laotawayi/-/微信图片_20240506144101.png

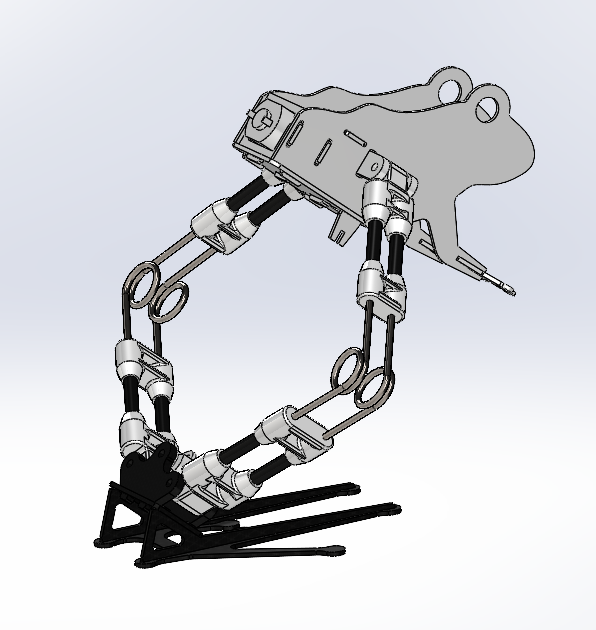
微信图片_20240506144101.png
