laotawayi/-/防尘板.STL

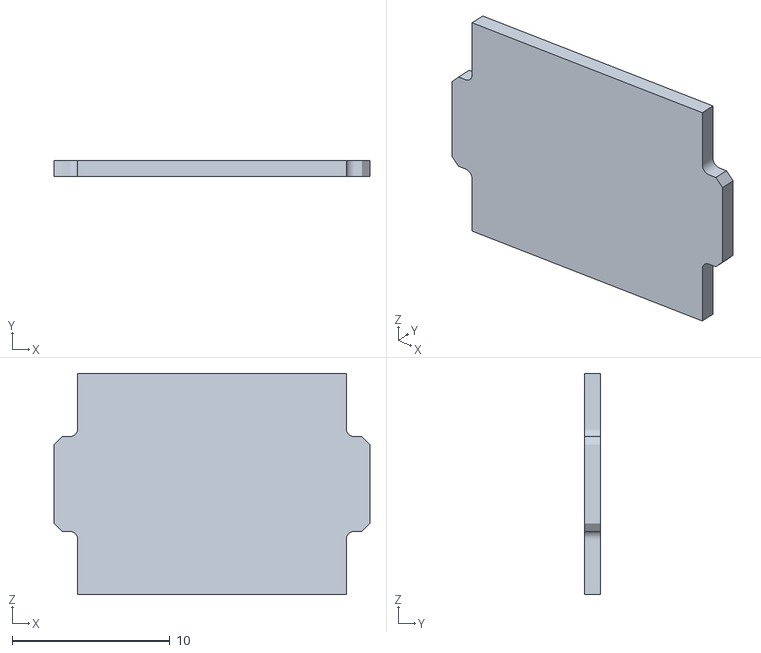
[picture p31: CAD file, 2024-05-06]
防尘板.STL
20.0 x 1.00 x 14.0
