laotawayi/-/腿加强筋.STL

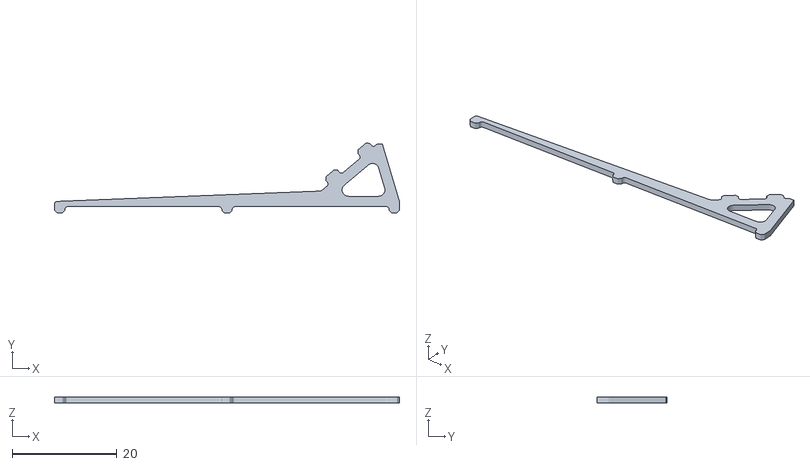
[picture p32: CAD file, 2024-05-06]
腿加强筋.STL
66.0 x 13.4 x 1.10
