laotawayi/-/挂钩V2.STL

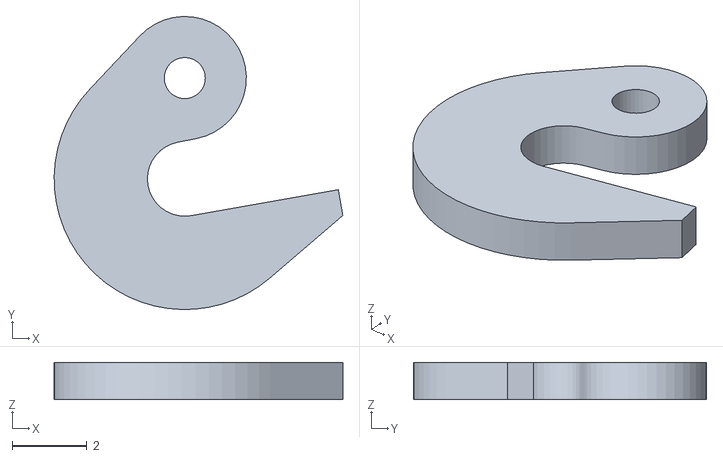
[picture p33: CAD file, 2024-05-06]
挂钩V2.STL
7.73 x 7.85 x 1.00
