laotawayi/-/底5.3.STL

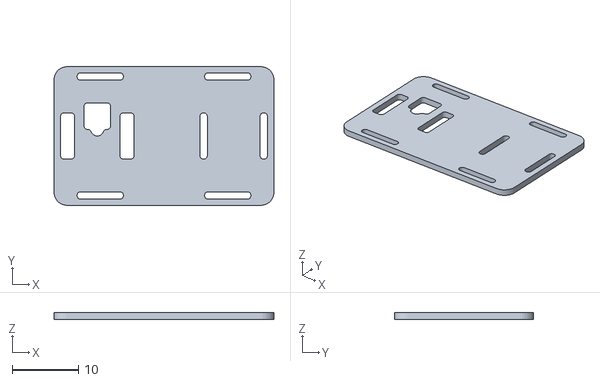
[picture p34: CAD file, 2024-05-06]
底5.3.STL
33.3 x 21.0 x 1.00
