laotawayi/-/正旋1.5mm扭簧.STL

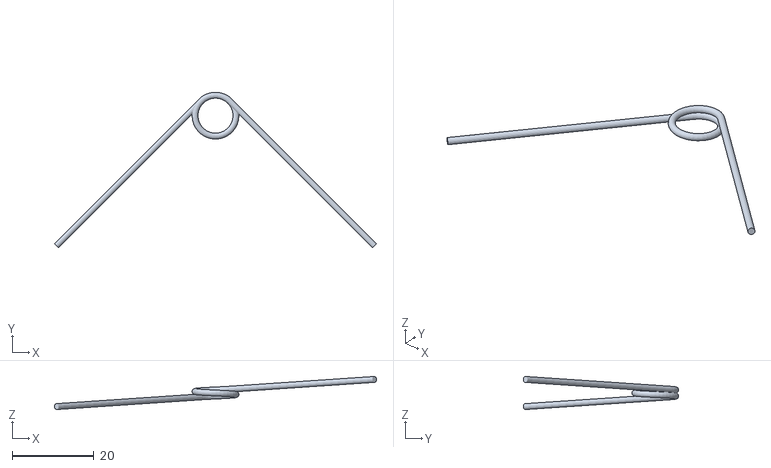
[picture p35: CAD file, 2024-05-06]
正旋1.5mm扭簧.STL
78.7 x 38.0 x 8.09
