laotawayi/-/转轴233.3.STL

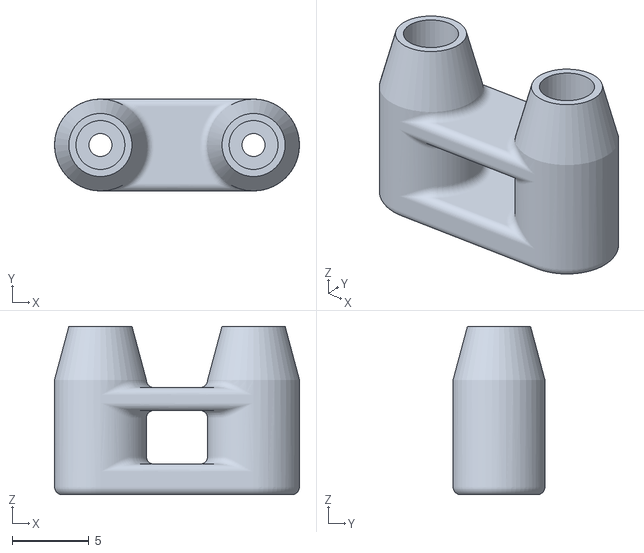
[picture p36: CAD file, 2024-05-06]
转轴233.3.STL
16.0 x 6.00 x 11.0
