laotawayi/-/转轴23.3.STL

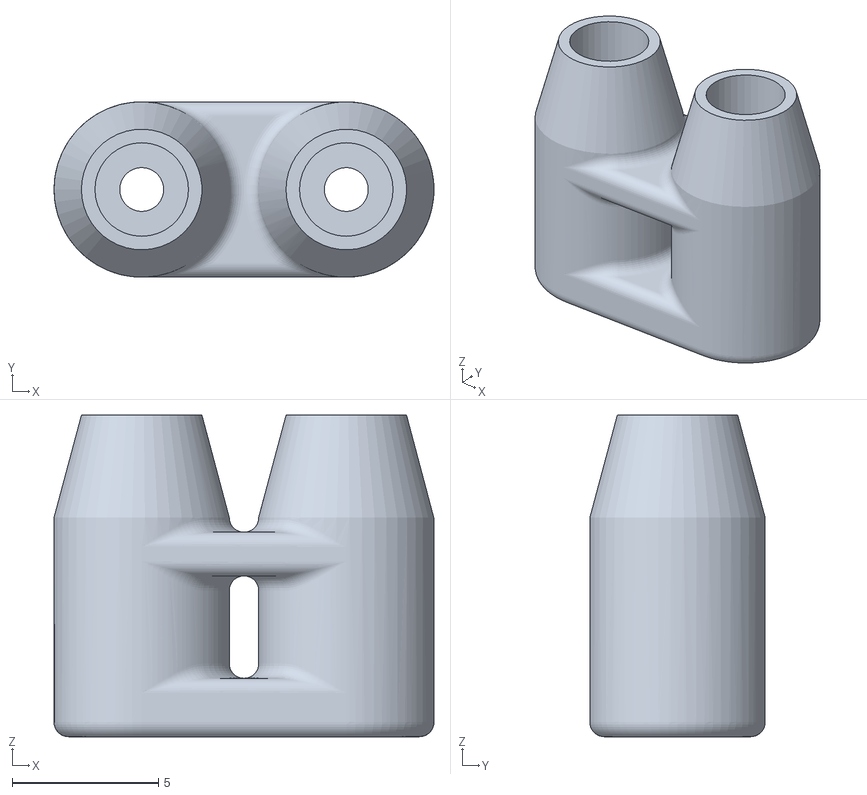
[picture p37: CAD file, 2024-05-06]
转轴23.3.STL
13.0 x 6.00 x 11.0
