laotawayi/-/电机.STL

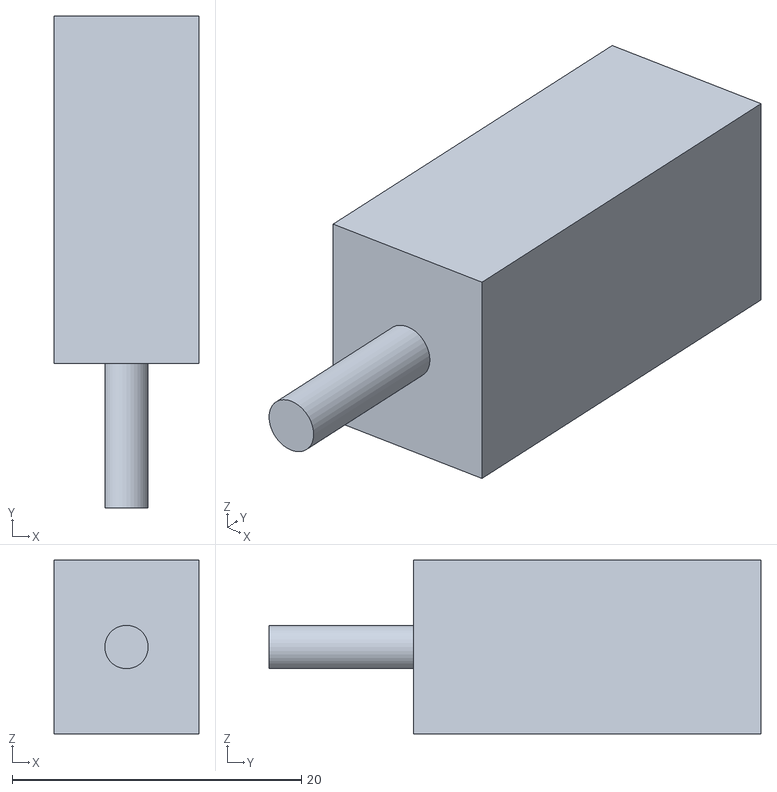
[picture p38: CAD file, 2024-05-06]
电机.STL
10.0 x 34.0 x 12.0
