laotawayi/-/脚底板5.3.STL

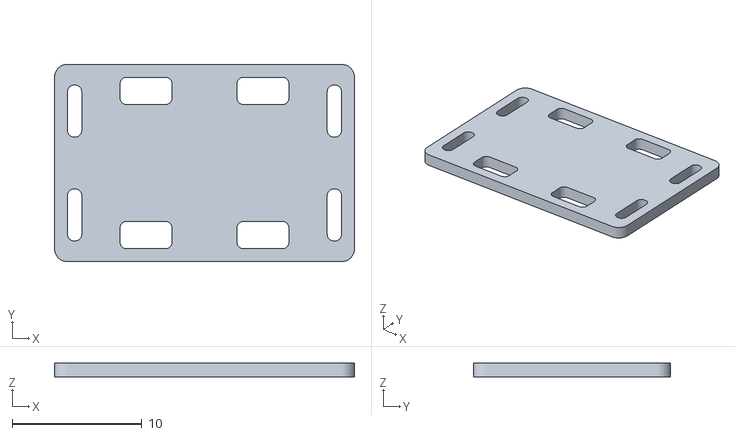
[picture p39: CAD file, 2024-05-06]
脚底板5.3.STL
23.1 x 15.2 x 1.10
