laotawayi/-/侧样子货３.STL

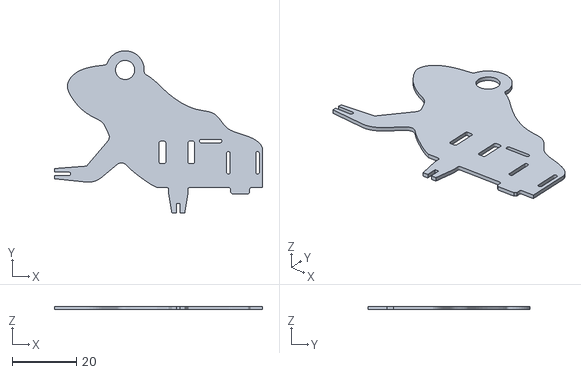
[picture p40: CAD file, 2024-05-06]
侧样子货３.STL
65.0 x 50.7 x 1.00
