laotawayi/-/转轴V5.1.STL

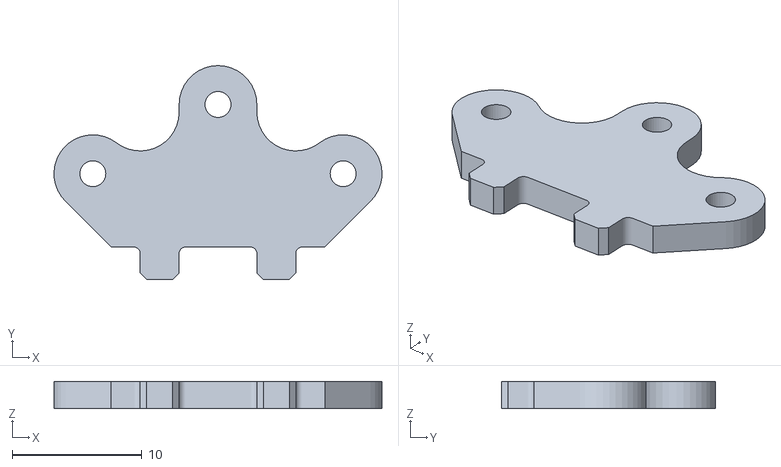
[picture p41: CAD file, 2024-05-06]
转轴V5.1.STL
25.3 x 16.5 x 2.10
