laotawayi/-/轴5.3.STL

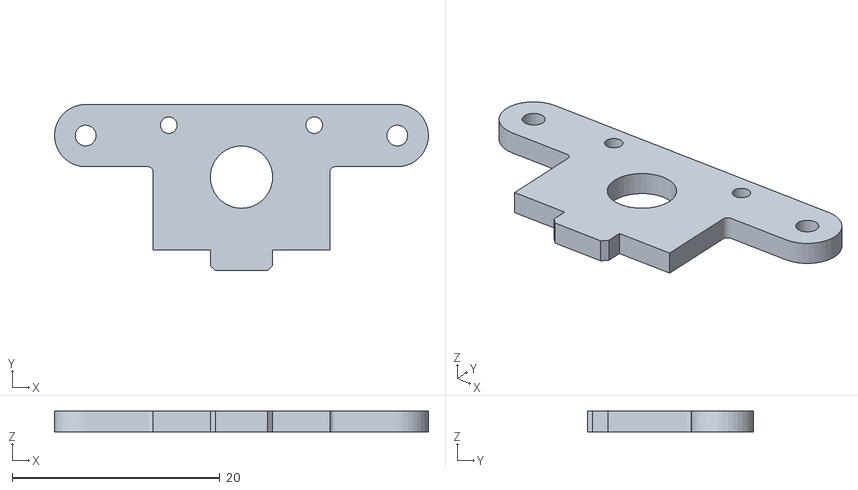
[picture p42: CAD file, 2024-05-06]
轴5.3.STL
36.0 x 16.0 x 2.00
