laotawayi/-/侧样子货.STL

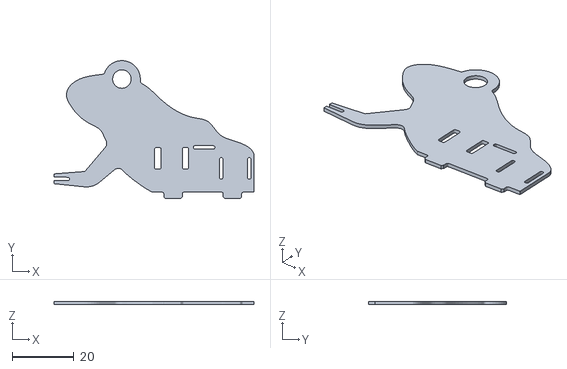
[picture p43: CAD file, 2024-05-06]
侧样子货.STL
65.0 x 44.7 x 1.00
