laotawayi/-/转轴3.3.STL

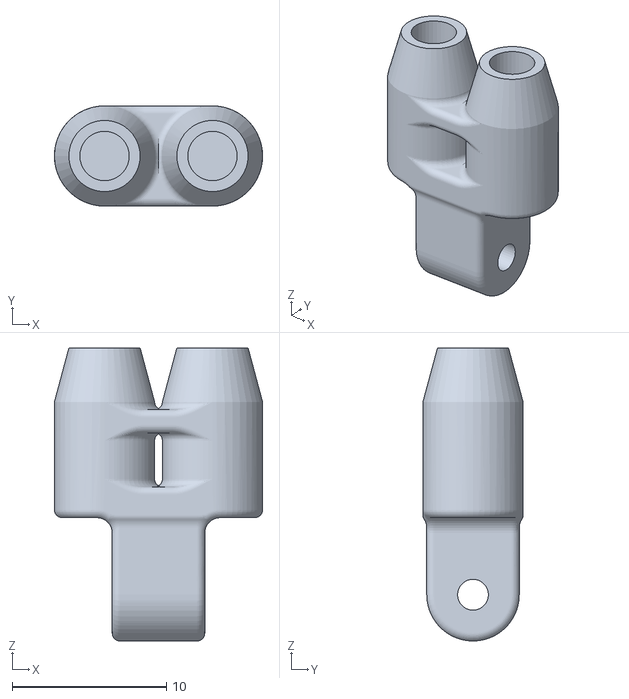
[picture p44: CAD file, 2024-05-06]
转轴3.3.STL
13.5 x 6.50 x 19.0
