laotawayi/-/轴25.3.STL

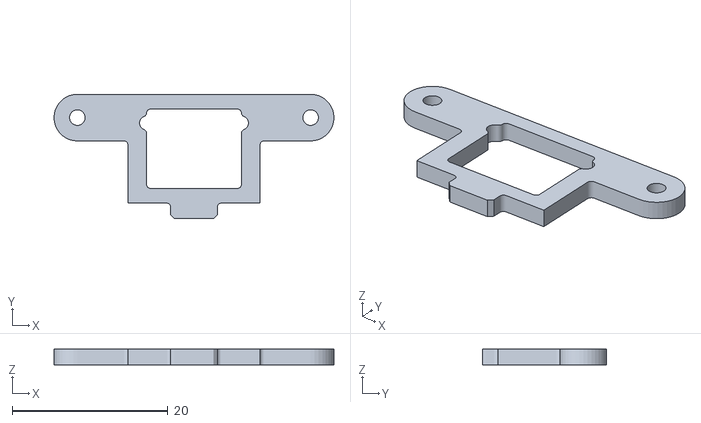
[picture p45: CAD file, 2024-05-06]
轴25.3.STL
36.0 x 16.0 x 2.00
