laotawayi/-/盒子.STL

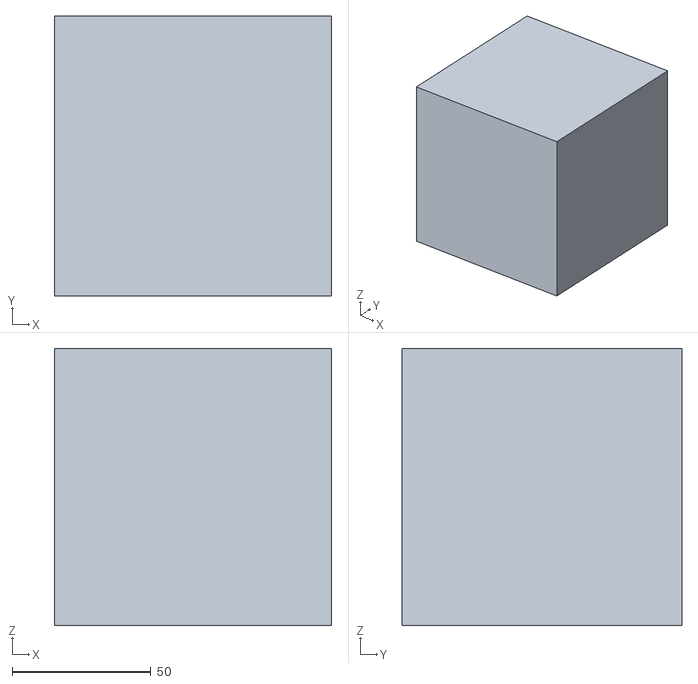
[picture p46: CAD file, 2024-05-06]
盒子.STL
100.0 x 101.0 x 100.0
