laotawayi/-/1.5碳纤维管.STL

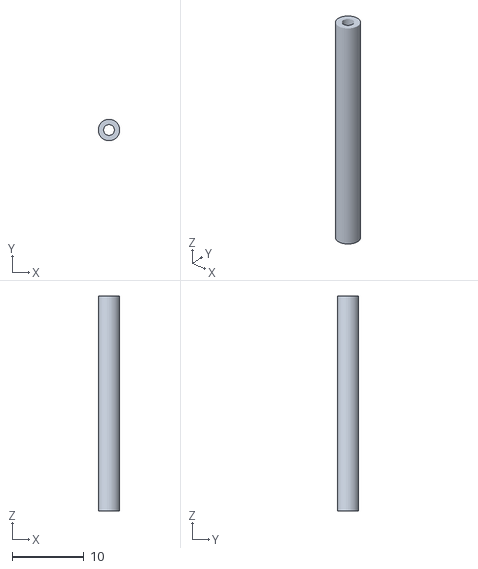
[picture p47: CAD file, 2024-05-06]
1.5碳纤维管.STL
3.00 x 3.00 x 30.0
