laotawayi/-/脚，加强.STL

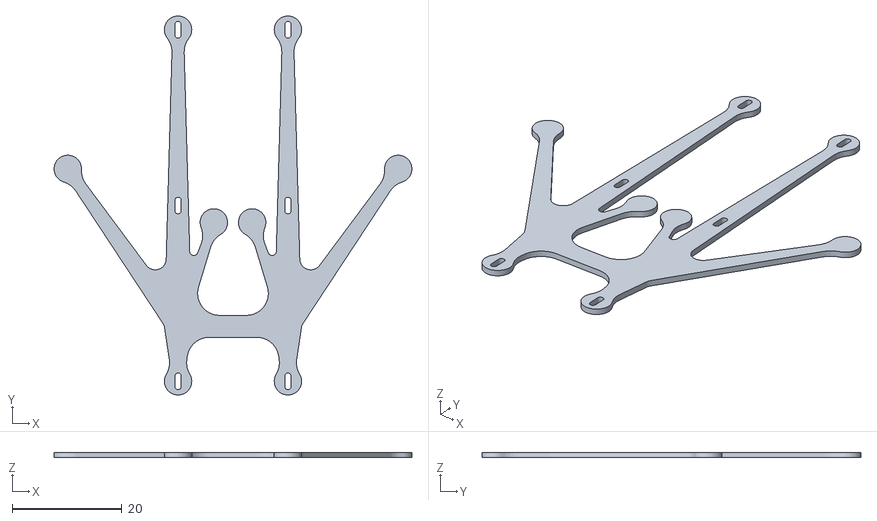
[picture p48: CAD file, 2024-05-06]
脚，加强.STL
65.1 x 69.0 x 1.00
