laotawayi/-/释放开关.STL

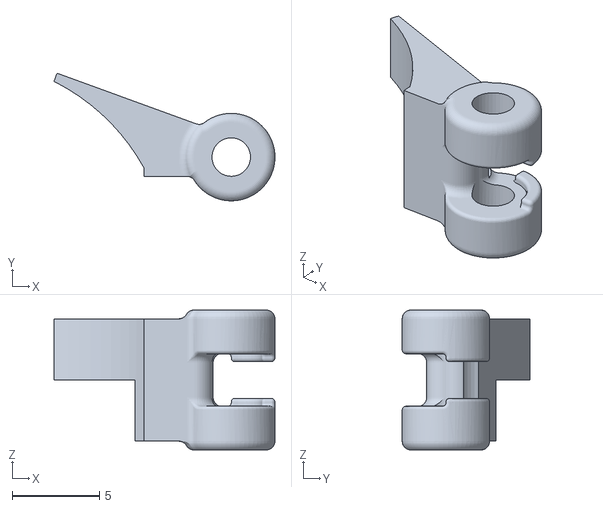
[picture p49: CAD file, 2024-05-06]
释放开关.STL
12.6 x 7.30 x 8.00
