laotawayi/-/前脚掌.STL

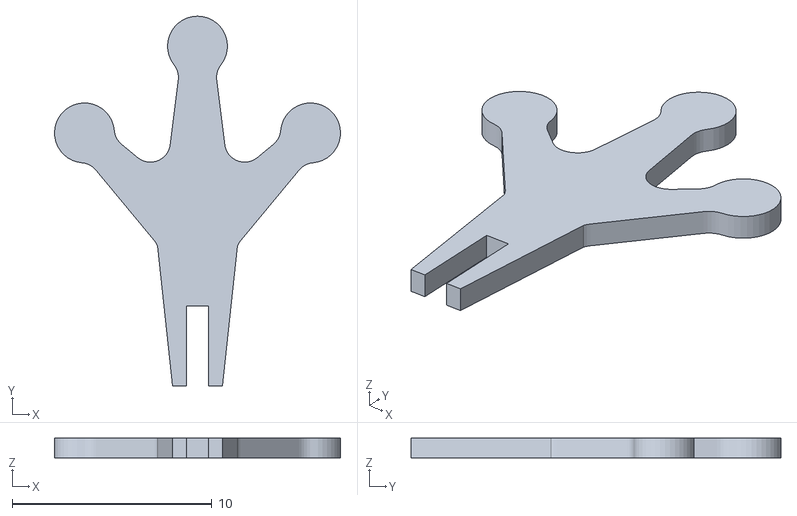
[picture p50: CAD file, 2024-05-06]
前脚掌.STL
14.3 x 18.5 x 1.00
