laotawayi/-/电机仓.STL

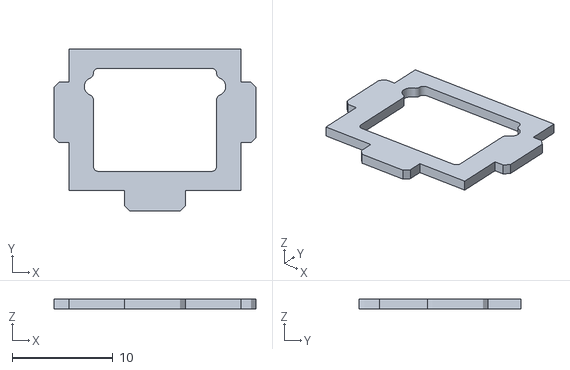
[picture p51: CAD file, 2024-05-06]
电机仓.STL
20.0 x 16.0 x 1.00
