laotawayi/-/转轴33.3.STL

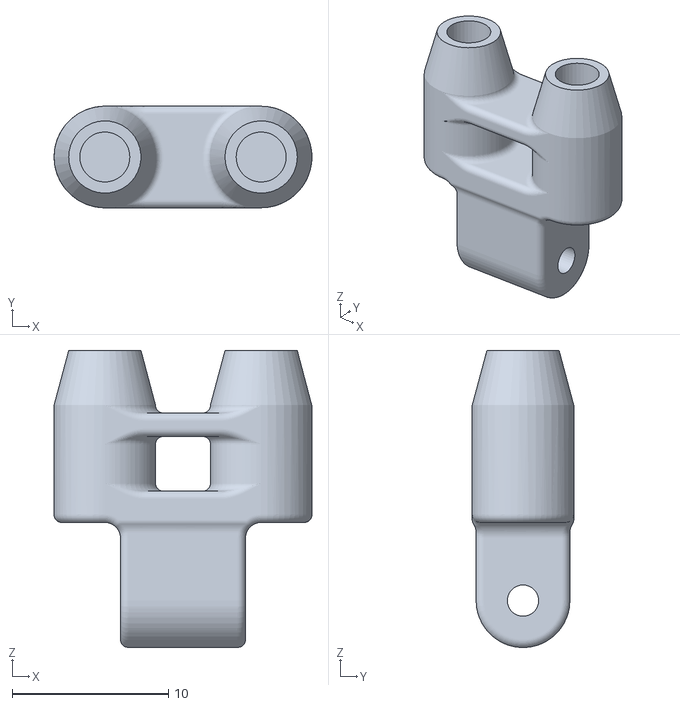
[picture p52: CAD file, 2024-05-06]
转轴33.3.STL
16.5 x 6.50 x 19.0
