laotawayi/-/(list of files, cad)

Other CAD files:
反旋1.5mm扭簧.STL
