laotawayi/-/(commit log)

2024-05-06 Add files via upload
    青蛙的模型文件
    [1.5碳纤维管.STL, 侧样子货.STL, 侧样子货３.STL, 前脚掌.STL, 反旋1.5mm扭簧.STL, 底5.3.STL, 挂钩V2.STL, 正旋1.5mm扭簧.STL]
2024-05-06 说明书范本
2024-05-06 模型照片文件
